rockola/Soliton/README.md

# Soliton
Provided to the DIY community for non-commercial use by Brian Thornock, copyright 2021

A classic vibe effect with modern digital controls.

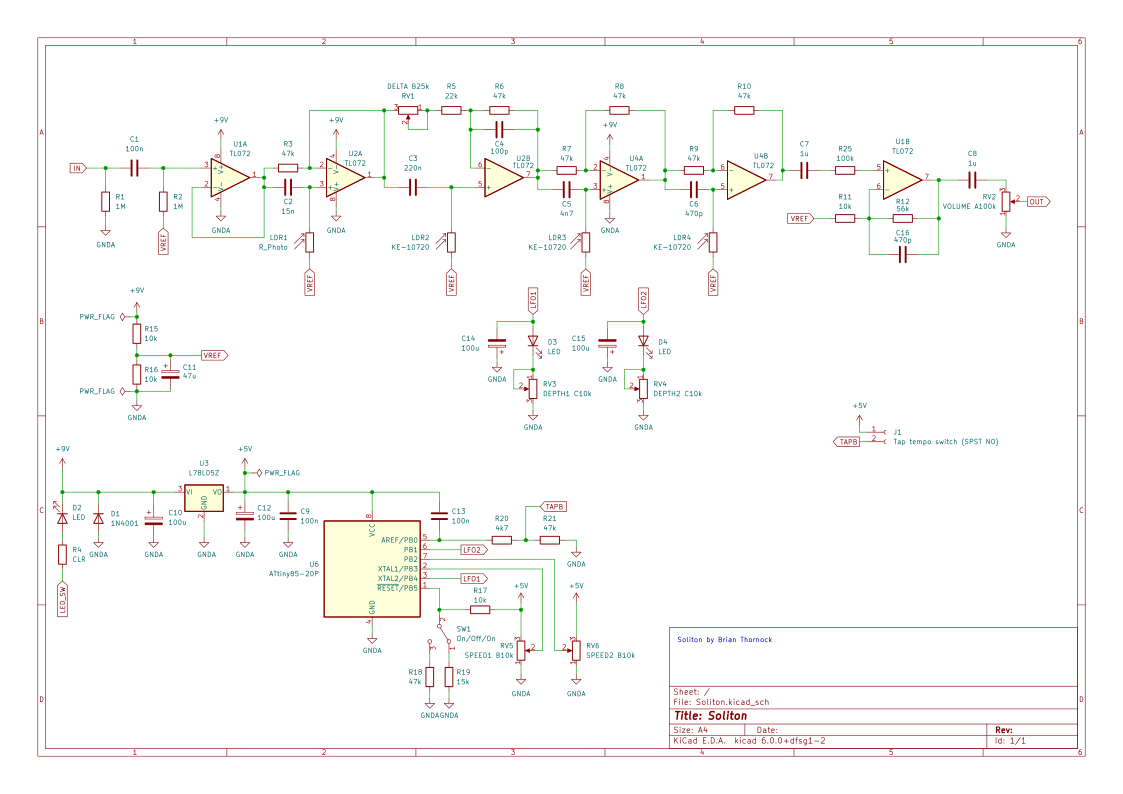
[picture p1: Soliton-schematic.png]
Soliton schematic
