rockola/Soliton/Soliton_Schematic.pdf

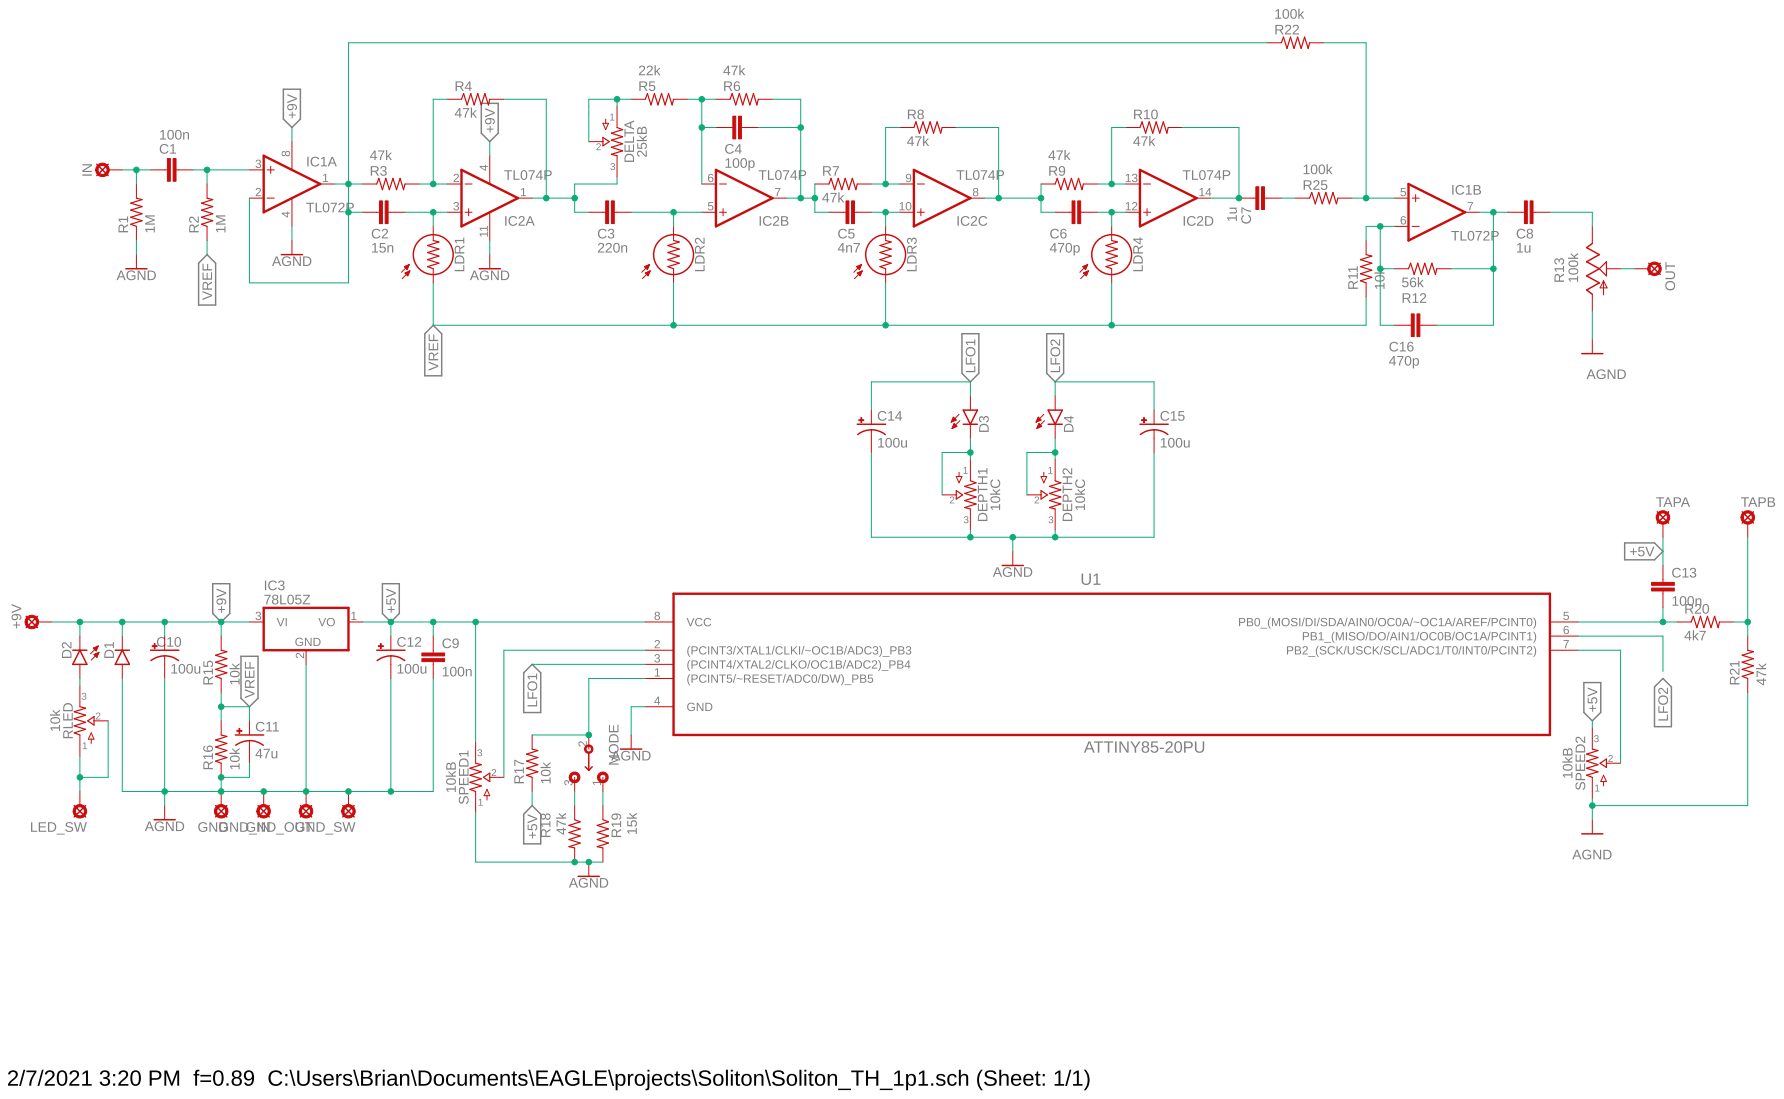
[picture p2: page 1]
