rockola/Soliton/Soliton.kicad_pcb

## KiCad design electronic_LED_circuit.kicad_sch

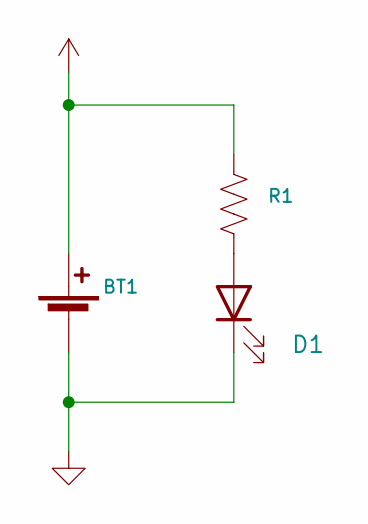
[picture p3: schematic electronic_LED_circuit.kicad_sch]

Parts:
BT1: (no value)
D1: (no value)
R1: (no value)

Connections:
unnamed: BT1.1 (+), R1.1
unnamed: BT1.2 (-), D1.1 (K)
unnamed: D1.2 (A), R1.2
