rockola/Soliton/Soliton.ino

#include <avr/io.h>
#include <avr/interrupt.h>
#include <util/atomic.h>

// Assign pins of ATTiny85, make sure it runs at 8 MHz internal oscillator

//DigitalPin Assignments
const unsigned int pwm1 = 4; //PWM out on OC1B/PCINT4/Pin3
const unsigned int pwm2 = 1; //PWM out on OC1A/PCINT1/Pin6
const unsigned int tapSwitch = 0; //Tap switch on PCINT0 so we can interrupt whenever tap tempo is pressed


//Analog Pin Assignments
const unsigned int rate1 = A3; //This will be an analog read of speed pot 1 on ADC3/PCINT3/Pin2
const unsigned int rate2 = A1; //This will be an analog read of speed pot 2 on ADC1/PCINT2/Pin7
const unsigned int modeSwitch = A0;


// Initiate the tap tempo button stuff
uint8_t buttonState; // Tap tempo button state used for debouncing
uint8_t lastButtonState = LOW; // Previous state of tap tempo switch
uint8_t tapStatus = LOW; // Current status of the tap tempo switch

unsigned long lastDebounceTime = 0; // initiate the debounce time counter
unsigned long debounceDelay = 30; // How long we enforce a debounce. Shouldn't be longer than minTime/2

uint8_t useTap = 0; // Flag for whether tap tempo has been populated or not
uint8_t updateTapTempo = 0; //Flag for whether the tap button has been pressed or not
uint8_t prevTaps = 0; // How many taps we have in our history
unsigned int tapTimeout; // The amount of time between taps necessary to discard the tap buffer
uint8_t maxTaps = 10; // Max number of taps to keep in history
uint8_t prevTimes [10]; // Array for storing the tap periods
unsigned int tapTime; // Averaged value of times in tap history
unsigned int prevTapTime; // Previous averaged tap tempo time
unsigned int prevTapDelay; // This is used for debouncing the tap tempo switch
uint8_t numPulses = 2; //This is how many pulses per tap tempo period

unsigned long rate1Time; // Current time value compared to the previous time to see if we need to move to the next table entry.
unsigned long prevRate1Time = 0; // Used to determine if we have changed rate enough that tap tempo should be used
unsigned long lastTime1; // Used for keeping track of whether we move to the next entry in our sineTable or not
unsigned long rate2Time; // Current time value compared to the previous time to see if we need to move to the next table entry.
unsigned long lastTime2; // Used for keeping track of whether we move to the next entry in our sineTable or not
unsigned long rateTol = 5 * 1000; //The number of microseconds of tolerance to see if we change rate1 period. Default is 5 ms.
unsigned long maxTime = 5e6; // Max time of 5s. This doesn't seem actually achievable, but whatever.
unsigned long minTime = 4e4; // Min time of 40 ms. This doesn't seem actually achievable, but whatever.
const uint8_t tableLength = 255; //Number of entries in our tables below
uint8_t inx1 = 0; //Index to read out of the table for PWM1, start at the beginning
uint8_t inx2 = 0; //Index to read out of the table for PWM2, start at the beginning
int dutyCycle1;
int dutyCycle2;

int outMode = 0; // We default to two independent sines, but this will be checked and corrected every loop if necessary

// Create a table for the PWM wave. Values are for 8 bit PWM (max value 255).
// Put it in flash memory so that it doesn't eat up our dynamic SRAM


//Sine
const uint8_t waveTable1[] PROGMEM = {127,130,133,136,139,143,146,149,152,155,158,161,164,167,170,173,176,179,181,184,187,190,193,195,198,200,203,205,208,210,213,215,217,219,221,223,225,227,229,231,233,235,236,238,239,
241,242,243,245,246,247,248,249,250,250,251,252,252,253,253,253,254,254,254,254,254,254,254,253,253,252,252,251,251,250,249,248,247,246,245,244,243,241,240,239,237,235,234,232,230,228,226,224,222,220,218,216,214,211,209,
207,204,202,199,196,194,191,188,186,183,180,177,174,171,168,166,163,159,156,153,150,147,144,141,138,135,132,129,125,122,119,116,113,110,107,104,101,98,95,91,88,86,83,80,77,74,71,68,66,63,60,58,55,52,50,47,45,43,40,38,36,
34,32,30,28,26,24,22,20,19,17,15,14,13,11,10,9,8,7,6,5,4,3,3,2,2,1,1,0,0,0,0,0,0,0,1,1,1,2,2,3,4,4,5,6,7,8,9,11,12,13,15,16,18,19,21,23,25,27,29,31,33,35,37,39,41,44,46,49,51,54,56,59,61,64,67,70,73,75,78,81,84,87,90,93,
96,99,102,105,108,111,115,118,121,124};

//Sine
const uint8_t waveTable2[] PROGMEM = {127,130,133,136,139,143,146,149,152,155,158,161,164,167,170,173,176,179,181,184,187,190,193,195,198,200,203,205,208,210,213,215,217,219,221,223,225,227,229,231,233,235,236,238,239,
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
145,143,141,139,137,135,133,131,129,126,124,122,120,118,116,114,112,110,108,106,104,102,100,98,96,94,92,90,88,86,84,82,80,78,76,74,72,70,68,66,64,62,60,58,56,54,52,50,48,46,44,42,40,38,36,34,32,30,28,26,24,22,20,18,16,14,12,10,8,6,4,2,0};
*/


// This table converts a linear taper speed pot to a logarithmically spaced array of pulse times. This is true logarithmic as opposed to a "log" pot and sounds much nicer
const int logTable[] PROGMEM = {1023,787,699,647,607,575,551,527,507,491,475,463,451,439,427,419,407,399,391,383,375,367,363,355,351,343,339,331,327,323,315,311,307,303,299,295,291,287,283,279,275,271,267,263,259,259,255,251,
247,247,243,239,235,235,231,227,227,223,219,219,215,215,211,207,207,203,203,199,199,195,191,191,187,187,183,183,179,179,179,175,175,171,171,167,167,163,163,163,159,159,155,155,151,151,151,147,147,147,143,143,139,139,139,135,
135,135,131,131,131,127,127,127,123,123,123,119,119,119,115,115,115,111,111,111,107,107,107,107,103,103,103,99,99,99,99,95,95,95,95,91,91,91,91,87,87,87,83,83,83,83,83,79,79,79,79,75,75,75,75,71,71,71,71,67,67,67,67,67,63,63,
63,63,59,59,59,59,59,55,55,55,55,55,51,51,51,51,51,47,47,47,47,47,43,43,43,43,43,39,39,39,39,39,39,35,35,35,35,35,31,31,31,31,31,31,27,27,27,27,27,27,23,23,23,23,23,23,19,19,19,19,19,19,15,15,15,15,15,15,15,11,11,11,11,11,11,
7,7,7,7,7,7,7,3,3,3,3};

void setup() {

  //Define pin modes
  pinMode(pwm1, OUTPUT);
  pinMode(pwm2, OUTPUT);
  pinMode(rate1, INPUT);
  pinMode(rate2, INPUT);
  pinMode(tapSwitch, INPUT);
  pinMode(modeSwitch, INPUT);

  // Initialize pin states
  digitalWrite(tapSwitch, LOW);
  digitalWrite(pwm1,LOW);
  digitalWrite(pwm2, LOW);
  analogWrite(pwm1,128);
  analogWrite(pwm2, 128);

  lastTime1 = micros(); // Get an initial value
  tapTimeout = 1.5 * maxTime; //How long to wait for taps

  // Set up timer/PWM items
  PLLCSR |= (1 << PLLE) | (1 << PCKE);

  // Set prescaler to PCK/2048
  TCCR1 |= (1 << CS10) | (1 << CS11) | (0 << CS12) | (0 << CS13) | (1<<PWM1A);
  
  // Set OCR1B compare value and OCR1C TOP value
  OCR1B = 128;
  OCR1C = 255;
  
  // Enable OCRB output on PB4, configure compare mode and enable PWM B
  DDRB |= (1 << PB4) | (1 << PB1);
  GTCCR |= (1 << COM1B0) | (1 << COM1B1);
  GTCCR |= (1 << PWM1B);

  TCCR1 |= (1 << COM1A0); // Set this bit to make sure that OCR1A starts up correctly. Not sure why, but it works.

  //Set up Interrupt items
  GIMSK = 0b00100000; //Enable pin change interrupts
  PCMSK = 0b00000001; //Enable PCINT0 for tap switch to be pin change interruptible

  sei(); // Start interrup service
}

void loop() {

  if (updateTapTempo) {
    checkTapTempo();
  }

  checkMode();

  updatePWM();

}



//Interrupt Handling
ISR (PCINT0_vect) {
  uint8_t readTap1 = digitalRead(tapSwitch);

  delayMicroseconds(2000); //Brute force debouncing
  uint8_t readTap2 = digitalRead(tapSwitch);

  if (readTap1 == readTap2) {
    updateTapTempo = 1;
  }
  
}



//Check what our mode switch is
void checkMode () {
  //Read the switch
  int switchVal = analogRead(modeSwitch);

  //Compare the value to our thresholds and make it the appropriate mode
  if (switchVal > 900) {
    //Default state (middle setting). Normal Sine mode operation.
    if (outMode != 0) {
      //Reset reading to beginning of wave table if we changed modes
      inx1 = 0;
      inx2 = 0;
    }
    outMode = 0;
  }
  else if (switchVal < 700) {
    //Single LED, compound LFO
    if (outMode != 1) {
      //Reset reading to beginning of wave table if we changed modes
      inx1 = 0;
      inx2 = 0;
    }
    outMode = 1;
  }
  else {
    //Golden Ratio Sine Mode. Ignores rate pot 2.
    if (outMode != 2) {
      //Reset reading to beginning of wave table if we changed modes
      inx1 = 0;
      inx2 = 0;
    }
    outMode = 2;
  }
}//End of checkMode()



//Update PWM outputs based on above settings
void updatePWM() {
  
  //Initialize some parameters
  int skip2 = (outMode == 1); //Could change this to also apply to other mode so that we don't have the golden ratio mode, but single bulb sine, two bulb sines, single bulb compound LFO
  int logTableVal = 0;
  
  //Calculate out the required time steps to reach before we go to the next step in the table.
  //Times are in microseconds

  int rate1Val = analogRead(rate1);
  
  //Find the closest value in the log table so we can use linear pots for logarithmic time spacing
  logTableVal = pgm_read_word(logTable + round(rate1Val/4));
  rate1Time = round(maxTime * logTableVal/1023);

  //Determine if we are using tapTime or not
  if (useTap == 1) {
    if (abs(rate1Time - prevRate1Time) <= rateTol) {
      //Tap tempo will be numPulses pulses, so divide tapTime by numPulses to become rate1Time
      rate1Time = round(tapTime * 1000/ numPulses); //Convert tap time to microseconds and divide by numPulses for the number of microseconds per full sine period
    }
    else {
      // We have changed enough that we need to no longer use tap tempo until it gets populated again
      useTap = 0;
    }
  }

  // Ensure that the time isn't too short
  if (rate1Time < minTime) {
    rate1Time = minTime;
  }
  
  //Convert microsecond period into amount of time between subsequent samples
  unsigned long rate1Step = round(rate1Time/tableLength);

  //Get the current time
  unsigned long currTime = micros();

  //Compare current time to last time we updated for each PWM out
  if ((currTime - lastTime1) > rate1Step) {
    //We have met the time threshold for PWM1, so go to the next value in the table
    dutyCycle1 = pgm_read_byte(waveTable1 + inx1);
    
    //If we aren't using compound LFO mode, go ahead and write the value
    if (skip2 != 1){
      OCR1B = dutyCycle1;
    }
    inx1+=1; //Increment the read index for PWM1
    
    // Go back to the beginning of the table if we have gotten to the end
    if (inx1 == tableLength) {
      inx1 = 0;
    }
    
    lastTime1 = micros();
  }//End of if ((currTime - lastTime1) > rate1Step)

  // Define what our rate2Time is. For outMode = 1, the value doesn't matter, so just give it something
  int rate2Val = 0;
  if (outMode == 0){
    rate2Val = analogRead(rate2);
    logTableVal = pgm_read_word(logTable + round(rate2Val/4));
    rate2Time = round(maxTime * logTableVal/1023);
  }
  else if (outMode == 2){
    rate2Time = round(1.618 * rate1Time);
  }
  else {
    rate2Time = round(maxTime * analogRead(rate2)/1023);
    
  }

  // Ensure the rate time isn't too short
  if (rate2Time < minTime) {
    rate2Time = minTime;
  }
  
  //Convert ms period into amount of time between subsequent samples
  unsigned long rate2Step = round(rate2Time/tableLength);

  //Get the current time
  currTime = micros();

  //Compare current time to last time we updated for each PWM out
  if ((currTime - lastTime2) > rate2Step) {
    //We have met the time threshold for PWM1, so go to the next value in the table
    dutyCycle2 = pgm_read_byte(waveTable2 + inx2);

    // Only write the PWM 2 if we aren't skipping
    if (skip2 != 1){
      analogWrite(pwm2,dutyCycle2);
    }
    inx2+=1; //Increment the read index for PWM1
    
    // Go back to the beginning of the table if we have gotten to the end
    if (inx2 == tableLength) {
      inx2 = 0;
    }
    
    lastTime2 = micros();
  }

  // If we aren't using PWM 2, shut off the LED
  if (skip2 == 1) {
    analogWrite(pwm2,0);
  }

  // If we are using the compound LFO, calculate it and apply
  if (outMode == 2) {
    int dutyCycle = round(dutyCycle1 * dutyCycle2/255);
    OCR1B = dutyCycle;
  }

  // Keep track of the previous rate 1 time so we can tell if we need to use tap tempo or the analog control
  prevRate1Time = rate1Time;
}// end of updatePWM()



void checkTapTempo() {

  //Check to see if the tap tempo switch has been pressed
  switchDebounce();

  if (tapStatus == HIGH) {
    tapStatus = LOW;
    //Check to see if we already have a tap tempo history. If so, add this to
    //the history. If not, start a new count.
    if (prevTaps > 0) {

      int currTime = millis();
      int currDelay = currTime - prevTapDelay;
      // Check to make sure we didn't time out
      if (currDelay < tapTimeout) {
        // Create the temp array for storing times in
        unsigned int newPrevTimes [maxTaps];

        if (prevTaps < maxTaps) {

          //Fill up the new array with all the old values first
          for (int k = 0; k < prevTaps - 1; k++) {
            newPrevTimes[k] = prevTimes[k];
          }

          //Then add in the new value at the end
          newPrevTimes[prevTaps - 1] = currDelay;
          prevTaps++;

        } // End if prevTaps < maxTaps
        // If we have filled the tap buffer

        for (int nTime = 0; nTime < maxTaps; nTime++) {
          prevTimes[nTime] = newPrevTimes[nTime];
        }

      } // End if currDelay < tapTimeout
      else {
        //If we timeout, reset the counter and zero out the tempo array
        prevTaps = 1;

        for (int i = 0; i < maxTaps; i++) {
          prevTimes[i] = 0;
        }
      } // End if tap has timed out
    } // End if prevTaps > 0
    // If we do not have any previous taps (first tap after timeout)
    else {
      prevTaps = 1;

      for (uint8_t i = 0; i < maxTaps; i++) {
        prevTimes[i] = 0;
      }
    }

    if (prevTaps > 2) {
      
      //Calculate the average polling time, including the multiplier and the random switch
      int sum, loop, numVals;
      float avg;

      sum = avg = 0;
      numVals = 0;

      for (loop = 0; loop < prevTaps - 1; loop++) {
        if (prevTimes[loop] != 0) {
          sum += prevTimes[loop];
          numVals++;
        }
      }
      avg = (float)sum / numVals;
      tapTime = round(avg);

      useTap = 1;
      
    }
    else {
      //If we don't have the information to produce a tap tempo, stick with what we have
    }
    prevTapDelay = millis();
  }

}// End of checkTapTempo()


//Code for debouncing tap tempo switch
void switchDebounce() {
  int8_t reading = digitalRead(tapSwitch);
  int8_t reading2 = 2; // Set to a value that can't be reached with digitalRead on purpose

  if (reading != lastButtonState) {
    delay(debounceDelay);
    reading2 = digitalRead(tapSwitch);
    
  }
  
  if (reading == reading2) {
    buttonState = reading;

    if (buttonState == HIGH) {
        tapStatus = HIGH;
    }
  }
  
  lastButtonState = reading;
}//End of switchDebounce()
