rockola/Soliton/(commit log)

2022-01-16 KiCad 6 files
    [Soliton.kicad_pcb, Soliton.kicad_sch]
2022-01-16 schematic export from KiCad
2022-01-16 added png schematic, copyright/author notice
2022-01-16 some tidying up
    [Soliton.kicad_sch]
